Lexzach/antigneous/misc/eol.png

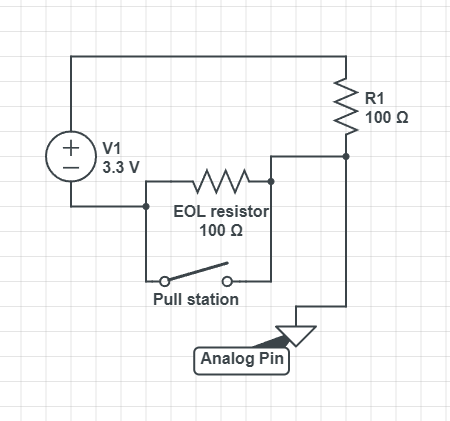
misc/eol.png
