Lexzach/antigneous/(commit log)

2022-10-01 documentation and trouble fix
    [main.cpp]
2022-10-04 failsafe mode, user defined smoke detector verification
    [main.cpp]
2022-10-07 starting strobe sync + 2 wire support
2023-03-21 arduino IDE
2023-03-26 separate zone 2 pin
2023-03-26 invert relay bool
2023-03-27 power on hours
2023-03-27 added power on hours
2023-03-28 assembly instructions
2023-03-28 removed incorrect schematic from tech instructions
2023-03-28 shortened some code and improved instructions
    [main.ino]
2024-01-03 fixed error code and instructions
    [main.ino]
